YaelTzadik/Control-Robotic-arm-using-EMG-of-upper-leg/README.md

# Control-Robotic-arm-using-EMG-of-upper-leg
Project B by Eden Ishay and Yael Tzadik
