YaelTzadik/Control-Robotic-arm-using-EMG-of-upper-leg/poster.pdf

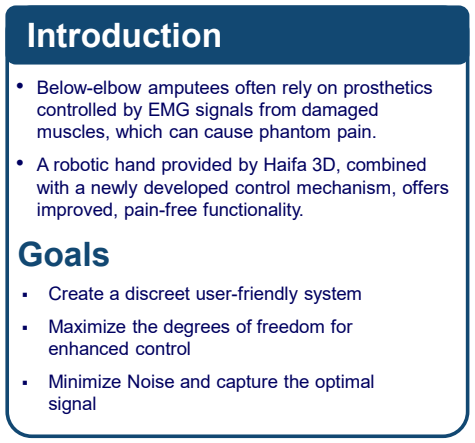
[picture p3: figure]
Introduction; controlled by EMG signals from damaged; improved, pain-free functionality. Goals; Maximize the degrees of freedom for enhanced control; signal
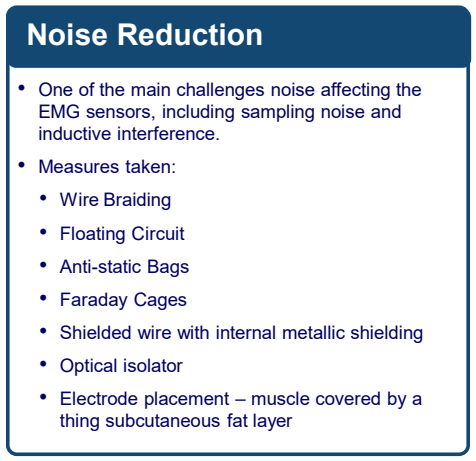
[picture p4: figure]
Deep Q-Networks; Training process; Noise Reduction; • Floating Circuit • Anti-static Bags; thing subcutaneous fat layer

- Below-elbow amputees often rely on prosthetics

muscles, which can cause phantom pain. • A robotic hand provided by Haifa 3D, combined

with a newly developed control mechanism, offers

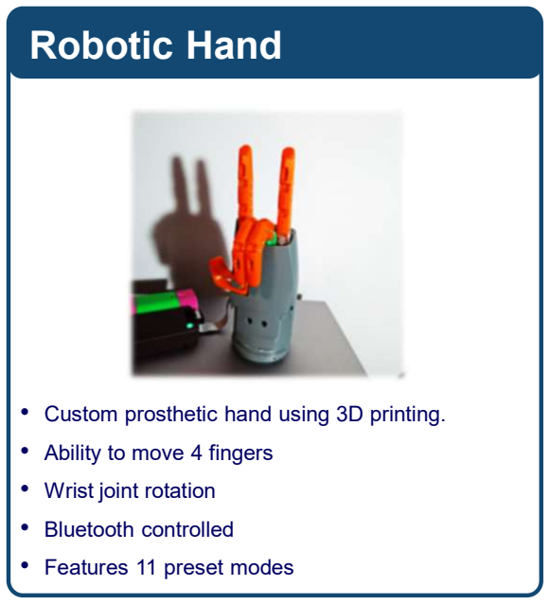
[picture p5: figure]
• Wrist joint rotation; • Bluetooth controlled; • Features 11 preset modes

# EMG Signal

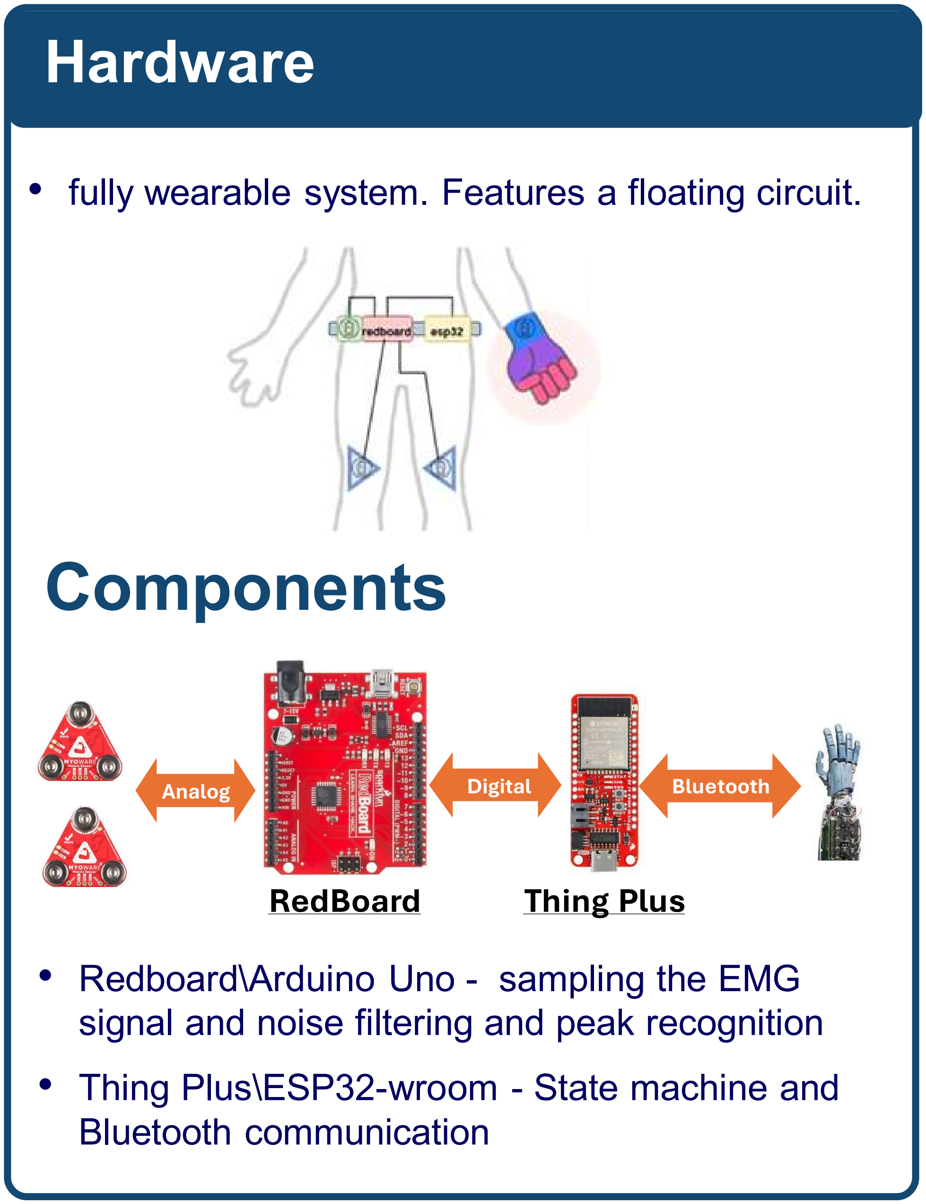
[picture p6: figure]
Hardware; Components; RedBoard; Thing Plus; Bluetooth communication

# Results

# Conclusions

- Best used as part of a multi-sensor system
- Long contraction detection might enable fine control • The sensors were found overly sensitive to noise
- A dual-core processor could replace the two current microcontrollers

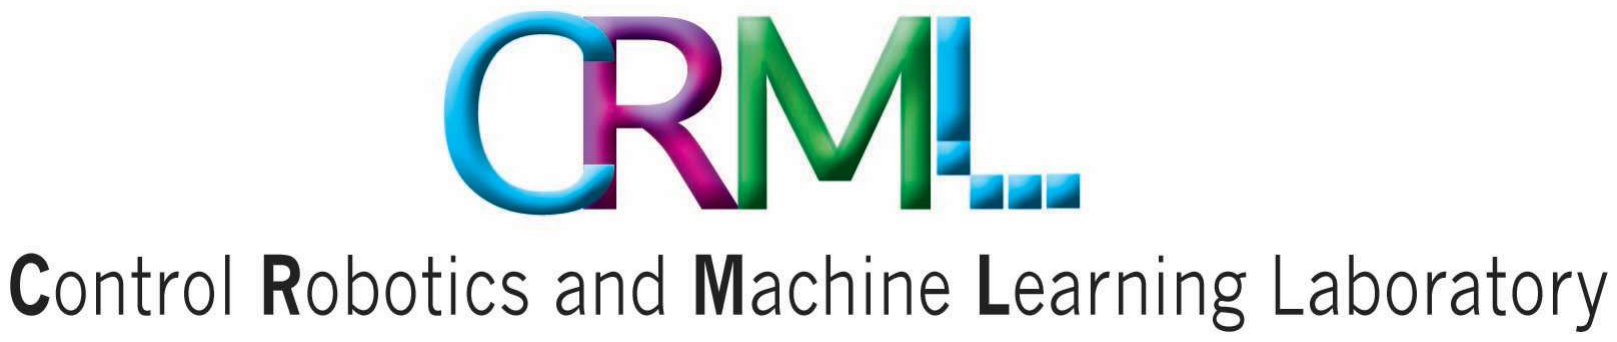
[picture p7: figure]

# Control of robotic arm using EMG sensor on upper leg

# Eden Ishay and Yael Tzadik, Supervised by Kobi Kohai

- Reliable System when seated or standing still. • Non-functional during walking • Good Recognition of both long and short ,muscle

contractions
- Operation become easier with practice

April 2025

- Create a discreet user-friendly system
- Minimize Noise and capture the optimal
- Electromyography) signals are electrical signals produced by muscle contractions. • They can be detected using Myoware sensors

with 3 electrodes: • MID – middle of the muscle. • END – toward the neuromuscular junction

- REF – neutral position or aligned with the line between MID and END.

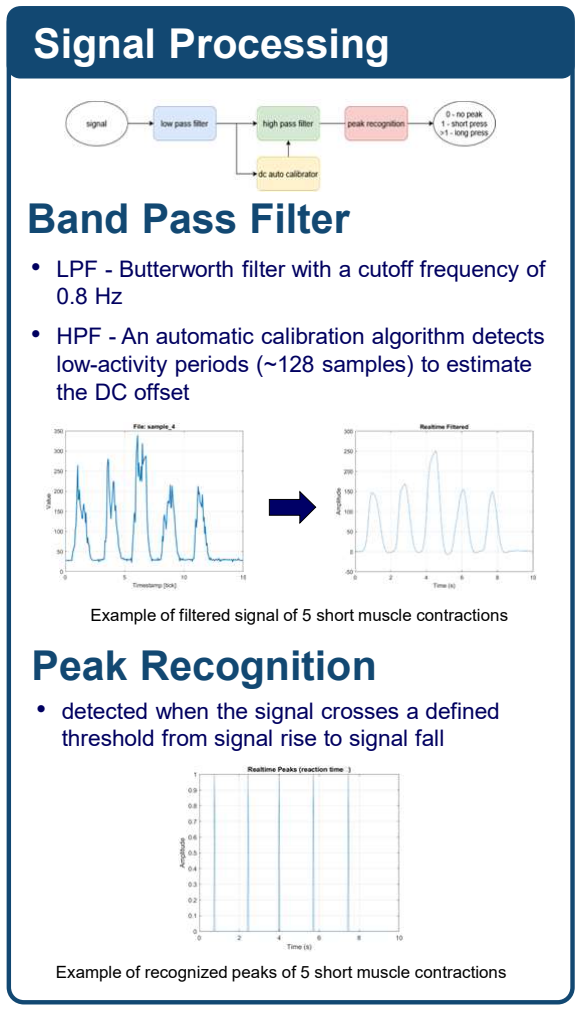
[picture p8: figure]
Signal Processing; Peak Recognition; the DC offset; Band Pass Filter

- detected when the signal crosses a defined threshold from signal rise to signal fall
Robotic Hand | Example of filtered signal of 5 short muscle contractions
- Custom prosthetic hand using 3D printing. • Ability to move 4 fingers
- LPF - Butterworth filter with a cutoff frequency of
- HPF - An automatic calibration algorithm detects low-activity periods (~128 samples) to estimate

Example of recognized peaks of 5 short muscle contractions

- One of the main challenges noise affecting the EMG sensors, including sampling noise and inductive interference. • Measures taken: • Wire Braiding
- Faraday Cages • Shielded wire with internal metallic shielding
- Optical isolator • Electrode placement – muscle covered by a

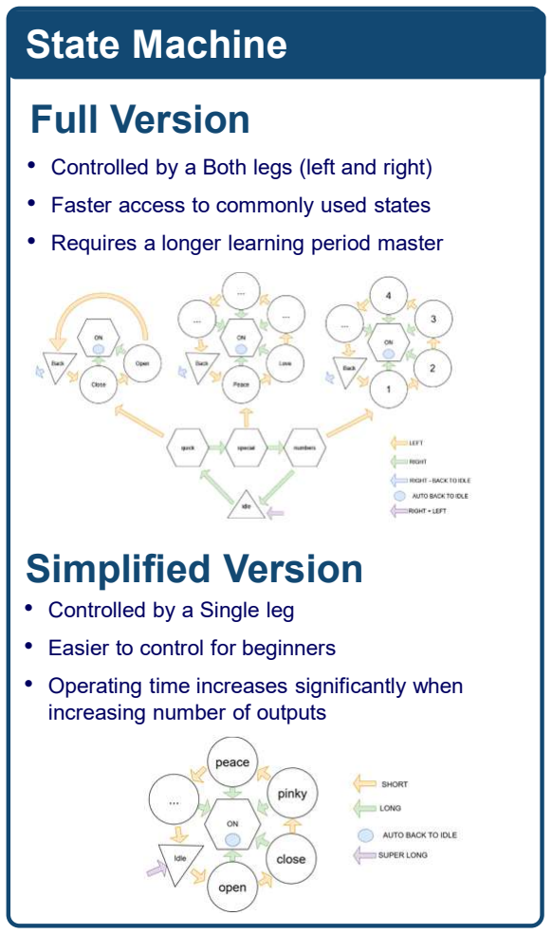
[picture p9: figure]
State Machine; Full Version; • Controlled by a Single leg; • Easier to control for beginners; increasing number of outputs; Simplified Version

- Operating time increases significantly when
- Controlled by a Both legs (left and right) • Faster access to commonly used states
- Requires a longer learning period master
- The strength of the signal is determined by the number of nerve and muscle fibers involved and the firing rate (frequency) of the motor units.

Myoware sensors \ Proper placement of the sensors on the Vastus intermedius muscle

- fully wearable system. Features a floating circuit.
Analog | Digital | Bluetooth • Redboard\Arduino Uno - sampling the EMG

signal and noise filtering and peak recognition
- Thing Plus\ESP32-wroom - State machine and
