YaelTzadik/Control-Robotic-arm-using-EMG-of-upper-leg/code/oparation version - 1 leg/esp32_blue_2_hand/Loop.cpp

//
// Created by ASUS on 29/10/2024.
//

#include "Loop.h"

Loop::Loop(int length)
{
    this->length = length;
    this->current = 0;
}

void Loop::next()
{
    this->current++;
    if (this->current == this->length)
        this->current = 0;
}

void Loop::reset()
{
    this->current = 0;
}

bool Loop::on_end()
{
    return this->current == (this->length-1);
}
